nobumin/water_temperature/power_supply.md

# power_supply.md — 電源設計メモ

DS18B20 温度 BLE ファームウェアの**電源供給・省電力に関する検討資料**です。
Raspberry Pi Pico W と ESP-WROOM-32D の 2 ボードを対象とします。

> **数値についての注意**: 本書の消費電流はデータシート典型値からの**概算**であり、
> 本プロジェクトの実機では未実測です。実際の値は上下します。
> 判断が電池寿命に依存する場合は、[8. 実測方法](#8-実測方法) に従って測定してください。

---

## 1. 結論（先に要点）

| 問い | 答え |
| --- | --- |
| ボタン電池（CR2032 等）で動くか | **動きません**。電圧ではなく**電流**が足りません |
| 現実的な電池は | **Pico W + 単4×2**（または 1S LiPo）。ESP32 は電池運用に不向き |
| どこに繋ぐか | Pico W = **VSYS(39) / GND(38)**、ESP32 = **3V3 ピン / GND**（3.0〜3.6V のみ） |
| ESP32 に自作基板は必須か | **必須ではありません**。目標寿命次第で 4 段階の選択肢があります |
| deep sleep で長寿命化できるか | BLE で検温要求を受ける構成とは**両立しません**（[6 章](#6-省電力の選択肢)） |

---

## 2. ボタン電池が使えない理由

### 2.1 電池側の供給能力

| 電池 | 公称電圧 | 容量 | 取り出せる電流の目安 |
| --- | --- | --- | --- |
| CR2032 | 3.0V | 約 220mAh | 連続 **1mA 程度**（パルスで 15mA 前後） |
| CR2450 | 3.0V | 約 600mAh | 連続 3mA 程度 |

CR2032 は内部抵抗が新品で 10Ω 前後、消耗すると 100Ω を超えます。

### 2.2 ボード側の要求

| ボード | 起動時ピーク | BLE アドバタイズ中 |
| --- | --- | --- |
| ESP-WROOM-32D | **約 300mA** | 約 40〜80mA |
| Pico W | 約 100mA | 約 30〜50mA |

100mA を引こうとした瞬間に 1V 以上ドロップし、**ブラウンアウトリセットで起動すらしません**。
容量的にも、仮に動いたとしても数時間の世界です。

### 2.3 参考: なぜ BLE ビーコン製品はボタン電池で動くのか

ボタン電池で動く BLE 製品が Nordic nRF52 系ばかりなのは、**送信時電流が 5〜8mA と桁違いに小さい**ためです。
ESP32 は送信 130mA 超のため、コイン電池とは根本的に相性が悪いです。
deep sleep を入れても、送信パルスを賄うのに 1000µF 級のバルクコンデンサが必要になる計算です。

---

## 3. 実用的な電源の選択肢

| 電源 | Pico W | ESP32 DevKit |
| --- | --- | --- |
| **単4 × 2（3.0V）** | ◎ VSYS へ直結。**最も手軽** | ✕ 電圧不足 |
| 単3 × 2（3.0V） | ◎ 容量重視ならこちら | ✕ 電圧不足 |
| 単3 × 3（4.5V） | ◎ VSYS へ | △ 5V ピンでは LDO のドロップアウト不足気味 |
| 単3 × 4（6V） | ◎ VSYS へ | ○ 5V ピンへ（差分は熱として捨てるため非効率） |
| **1S LiPo（3.7V）** | ◎ VSYS へ直結。**最小サイズ** | △ 直結不可。要 3.3V レギュレータか 5V 昇圧 |
| モバイルバッテリー（USB 5V） | ◎ | ◎ 最も手軽 |

**Pico W のほうが電池運用は圧倒的に有利です。** VSYS が **1.8〜5.5V 対応の昇降圧レギュレータ**
入力になっており、電圧が下がっても昇圧して使い切れるためです。

### 3.1 体積あたりの実効エネルギー（目安）

| 電源 | 実効エネルギー | 体積の目安 |
| --- | --- | --- |
| 単3×4（ESP32・LDO 経由） | 約 5Wh | 60×58×17mm |
| 単3×2（Pico W・VSYS） | 約 4Wh | 30×58×17mm |
| **1S LiPo 1000mAh**（Pico W） | 約 3.1Wh | **35×20×5mm** |
| モバイルバッテリー 5000mAh | 約 13Wh | 90×60×12mm |

小容量帯では **LiPo が圧倒的に小型**です。ケースに収めるなら Pico W + 1S LiPo が最もコンパクトになります。

### 3.2 乾電池を選ぶ理由

サイズでは LiPo に劣りますが、次の利点があります。

- どこでも入手・交換できる
- 低温に強い（LiPo は氷点下で急激に性能が落ちる）
- 発火リスクが低く、輸送規制も緩い
- 充電回路が不要

屋外設置や、エンドユーザーが自分で電池交換する製品なら、多少大きくても乾電池が妥当な場合があります。

### 3.3 モバイルバッテリーの落とし穴

**多くのモバイルバッテリーは低電流だと自動で給電を停止します。**
「機器が外された」と判断する閾値がだいたい 50〜100mA 前後にあるためです。

- 現行ファーム（BLE 待受で 30〜50mA） → **製品によっては数十秒で切れます**
- deep sleep を実装した後（µA オーダー） → **ほぼ確実に切れます**

低電流モード付きの製品を選ぶか、常用電源にしない判断が必要です。

---

## 4. 接続図：Pico W（推奨構成）

写真と同じ向き（USB が上、アンテナが下）。

```
                    ┌────────── USB（上）──────────┐
          GP0    1 ─┤ ●                          ● ├─ 40  VBUS      （使わない）
          GP1    2 ─┤ ●                          ● ├─ 39  VSYS      ◄══ 電池 ＋
          GND    3 ─┤ ●                          ● ├─ 38  GND       ◄══ 電池 −
          GP2    4 ─┤ ●                          ● ├─ 37  3V3_EN    （GND に落とすと電源 OFF）
          GP3    5 ─┤ ●                          ● ├─ 36  3V3(OUT)  ◄── DS18B20 VDD ＋ 4.7kΩ
          GP4    6 ─┤ ●                          ● ├─ 35  ADC_VREF
          GP5    7 ─┤ ●                          ● ├─ 34  GP28
          GND    8 ─┤ ●                          ● ├─ 33  GND (AGND)
          GP6    9 ─┤ ●         Pico W           ● ├─ 32  GP27
          GP7   10 ─┤ ●                          ● ├─ 31  GP26
          GP8   11 ─┤ ●                          ● ├─ 30  RUN
          GP9   12 ─┤ ●                          ● ├─ 29  GP22
          GND   13 ─┤ ●                          ● ├─ 28  GND
          GP10  14 ─┤ ●                          ● ├─ 27  GP21
          GP11  15 ─┤ ●                          ● ├─ 26  GP20
          GP12  16 ─┤ ●                          ● ├─ 25  GP19
          GP13  17 ─┤ ●                          ● ├─ 24  GP18
          GND   18 ─┤ ●                          ● ├─ 23  GND
          GP14  19 ─┤ ●                          ● ├─ 22  GP17
  ◄──★    GP15  20 ─┤ ●                          ● ├─ 21  GP16
                    └───── アンテナ / CYW43（下）─────┘

  ◄──★  DS18B20 DQ ＋ 4.7kΩ で 3V3(OUT) へプルアップ
```

回路図として書くと次のとおりです。

```
   電池 ＋ ──[ ショットキー 1N5817 ]──┬────────── 39  VSYS
                                      │
                                  [ 100µF ]      ← 突入電流の緩和
                                      │
   電池 −  ─────────────────────────┴────────── 38  GND
                                                    │
   3V3(OUT) 36 ──┬──[ 4.7kΩ ]──┬                    │
                 │             │                    │
   DS18B20 VDD ──┘             │                    │
   DS18B20 DQ  ────────────────┴───────── GP15 (20) │
   DS18B20 GND ──────────────────────────────────────┘
```

### 4.1 注意点

- **直列ショットキーダイオードを推奨**します。USB を挿すと VBUS から内部ダイオード経由で
  VSYS に約 4.7V が現れるため、これが無いと一次電池（充電不可）に逆流します。
  USB を使うときは電池を外す運用なら省略できます。
- **3V3_EN（37 番）を GND に落とすとレギュレータが止まります。**
  ここにスライドスイッチを入れれば電源スイッチになります。
- **VBUS(40) や 3V3(OUT)(36) に電池を繋いではいけません。** 前者は USB へ逆流し、
  後者はレギュレータをバイパスします。

---

## 5. 接続図：ESP32 DevKit

```
              ┌──── アンテナ（写真の上）────┐
       3V3 ──┤ ●                          ● ├── GND   ◄══ 電池 −
        EN ──┤ ●                          ● ├── 23
       ▲▲▲
   ◄══ 電池 ＋（3.0〜3.6V に安定化されたもののみ）
        VP ──┤ ●                          ● ├── 22
        VN ──┤ ●                          ● ├── TX
        34 ──┤ ●                          ● ├── RX
        35 ──┤ ●                          ● ├── 21
        32 ──┤ ●                          ● ├── GND
        33 ──┤ ●                          ● ├── 19
        25 ──┤ ●                          ● ├── 18
        26 ──┤ ●                          ● ├── 5
        27 ──┤ ●                          ● ├── 17
        14 ──┤ ●                          ● ├── 16
        12 ──┤ ●                          ● ├── 4     ◄── DS18B20 DQ ★
       GND ──┤ ●                          ● ├── 0
        13 ──┤ ●                          ● ├── 2
        D2 ──┤ ●                          ● ├── 15
        D3 ──┤ ●                          ● ├── D1
       CMD ──┤ ●                          ● ├── D0
        5V ──┤ ●                          ● ├── CLK
       ▲▲
   4.5V 以上の電源はこちら（オンボード LDO 経由）
              └──── micro-USB（写真の下）────┘
```

電圧によって挿す場所が変わります。

| 電源電圧 | 接続先 | 備考 |
| --- | --- | --- |
| 3.0〜3.6V（安定化済み） | **3V3 ピン** | LDO をバイパス。逆接保護なし |
| 4.5V 以上 | **5V ピン** | オンボード AMS1117 経由。ドロップアウト約 1.1V |
| 3.7V（LiPo 直結） | **どちらも不可** | 3V3 には高すぎ、5V ピンには足りない。要レギュレータ |

### 5.1 注意点

1. **3V3 ピン給電中に USB を挿さないでください。** AMS1117 の出力と電池がぶつかります。
2. **DevKit は電池運用に向きません。** USB-シリアル変換の CP2102 とオンボード LDO が
   常時 5〜10mA を消費し、MCU 側をいくら絞っても板全体では下がりません。

---

## 6. 省電力の選択肢

### 6.1 モードの実力（ボード別）

| モード | ESP32 | RP2040 (Pico W) |
| --- | --- | --- |
| 通常動作（BLE 送信中） | 40〜80mA | 30〜50mA |
| light sleep（RAM 保持） | 約 0.8mA | SLEEP: 約 1.3mA |
| **deep sleep** | **約 10µA** | DORMANT: チップ単体 約 180µA |
| 起床方法 | RTC タイマ / GPIO / タッチ | **原則 GPIO のみ** |

- **ESP32**: `esp_hal` に `Rtc::sleep_deep()` / `sleep_light()` があり、タイマ起床も使えます。
- **RP2040**: `embassy-rp` に `dormant_sleep()` はありますが、「リセットか dormant-wake GPIO 割り込みでしか
  抜けられない」実装です。定期的に自力で起きるには外部 RTC か 32kHz 発振器が必要になります。
- **Pico W 固有の制約**: CYW43439 は電源を切ると、次回起動時に**数百 KB のファームウェア blob を
  SPI で転送し直す**必要があります（`scripts/fetch-cyw43-firmware.sh` で取得しているもの）。
  頻繁な sleep/wake は、この転送の時間とエネルギーが省電力分を食い潰します。

> **まとめ**: Pico W は「電池電圧の扱いは優秀だが deep sleep には不向き」、
> ESP32 は「deep sleep は得意だが DevKit ではその恩恵が出ない」という、やや噛み合わない特性です。

### 6.2 最大のトレードオフ

> **寝ている間は BLE アドバタイズが止まる = スマホから見えない。**

本ファームは**オンデマンド検温**（検温要求の GATT Write で 60 秒間だけ測定）ですが、
**その要求を受け取るには無線が生きている必要があります**。BLE の原理上の制約であり、
ライブラリの制限ではありません。

| 動作モデル | 見え方 | 消費電流 |
| --- | --- | --- |
| **A. 常時アドバタイズ待受**（現行） | いつでも要求できる | 大 |
| **B. 定期ビーコン**（deep sleep） | 送信窓に居合わせないと見えない | 極小 |
| **C. 物理ボタン + deep sleep** | ボタンを押せば即応答 | 極小 |

現行ファームは **A** です。**C** に移行する場合も、トリガを `ble::REQUEST` シグナルへ
合流させれば BLE 側のコードは変更不要な構造にしてあります（`specification.md` 5.4 節）。

### 6.3 消費電流の内訳（重要）

**オンデマンド検温化だけでは消費電流はあまり下がりません。**

| 要素 | 支配度 | オンデマンド化で下がるか |
| --- | --- | --- |
| **CPU と無線のアイドル電流** | **最大** | **下がらない** |
| アドバタイズ間隔 160ms → 1000ms | 中 | 下がる（実装済み） |
| 測定の停止（DS18B20 の変換） | 小 | 下がる（実装済み） |
| Notify の停止 | 小 | 下がる（実装済み） |

大幅に下げるには **light sleep / modem sleep のパワーマネジメントが別途必要**です。
現行ファームはこれを一切設定していません。

---

## 7. 電池寿命の試算

**前提**: 1 日 10 回・各 1 分の検温、単4×2（約 1000mAh）。いずれも**未実測の概算**です。

| 構成 | 待機電流 | 目安 |
| --- | --- | --- |
| Pico W（現行・オンデマンドのみ） | 15〜30mA | **1.5〜3 日** |
| ESP32 DevKit（現行） | 30〜50mA | 約 1 日 |
| ESP32 自作基板（＋light sleep） | 3〜10mA | 4 日〜2 週間 |
| ESP32 自作基板（ボタン + deep sleep） | 約 10µA | **約 5 ヶ月** |

最終行まで到達すると、寿命が**待機電流ではなく検温回数で決まる**ようになります。ここが設計の分かれ目です。

---

## 8. 実測方法

概算に頼らず、実機で測るのが確実です。

1. 電池と基板の間に**テスターを直列**に挿入する（電流モード、mA レンジ）
2. 次の 3 状態で測る
   - 待受中（検温要求を出していない状態）
   - 検温中（Write 直後の 60 秒間）
   - 起動時のピーク（可能なら）
3. 結果を `test_procedure.md` の実機記録に残す

ファームウェアの変更前後で比較すれば、省電力施策の効果を数値で確認できます。

---

## 9. 製品化する場合の検討事項

PoC から製品へ進める段階で必要になる項目です。

### 9.1 基板の選択肢

| | 方法 | 待機電流 | 手間 |
| --- | --- | --- | --- |
| **A** | DevKit をそのまま使う | 30〜50mA | なし |
| **B** | DevKit を改造（CP2102 の電源カット、LDO バイパス） | 改善するが保証外 | 中・要はんだ作業 |
| **C** | 電池運用向けの既製 ESP32 ボードを選ぶ | 大幅改善 | 小・買い替えのみ |
| **D** | ESP32 モジュール直載せの自作基板 | 最良 | 大 |

判断基準:

- **USB 給電が前提で電池は予備** → A で十分
- **数日もてばよい** → A か C
- **数週間〜数ヶ月** → C か D ＋ light sleep 実装が必須

### 9.2 技適（日本国内）

ESP-WROOM-32D は**モジュール単体で工事設計認証を取得済み**です。モジュールを改変せず、
指定された条件（内蔵 PCB アンテナをそのまま使う等）を守れば、原則として最終製品での
再認証は不要になります。ただし**製品に技適マークの表示義務**があり、条件の詳細は
モジュールの認証情報で確認が必要です。

> 自己判断せず、Espressif の資料か認証機関に確認してください。

### 9.3 回路設計

| 項目 | 内容 |
| --- | --- |
| 電源 | DevKit の AMS1117 は効率・待機電流とも悪い。電池駆動なら低 Iq LDO か降圧 DC-DC へ |
| 書き込み | USB-シリアルを載せるか、UART + EN/IO0 をテストパッド（ポゴピン用）として出す。OTA を実装すれば量産後の更新が楽 |
| アンテナ | モジュールのアンテナ部は基板から張り出させ、直下と周囲を**銅箔・GND 禁止**にする。金属ケースは BLE を大きく殺す |
| コネクタ | DS18B20 が防水プローブなら JST XH / 端子台 / 屋外なら M12 など |

### 9.4 1-Wire の外部配線（本プロジェクト固有）

センサをケーブルで外に出す＝**ESD とノイズの入口**になります。ブレッドボードでは不要でも、
製品では次を検討してください。

- DQ に直列 100Ω 程度 ＋ **ESD/TVS ダイオード**
- ケーブルが長い（数 m 以上）場合はプルアップを 2.2kΩ 程度に下げる、または 1-Wire ラインドライバ

ESP32 のソフトビットバンギングは**タイミング余裕が小さい**ため（`specification.md` の
「µs 待機の実装はボード固有」節を参照）、ケーブルが伸びるほど不利です。製品化するなら
**RMT ペリフェラルによるハードウェア生成**への移行を検討する価値があります。

### 9.5 ボード選定の見直し

新規に基板を設計するなら、**ESP32-C3 / C6 への移行**を検討する価値があります。

- **stable Rust で扱える**（RISC-V）。`espup` や Xtensa フォークのツールチェーンが不要になり、CI も単純化される
- BLE 5.x 対応、モジュール単価も安い
- 本プロジェクトの `core` クレートはそのまま流用でき、`ble.rs` もほぼ同一のはず

コイン電池で数年動く BLE センサを目指す場合は、Nordic nRF52 系が本命です。

---

## 10. 関連ドキュメント

| ファイル | 内容 |
| --- | --- |
| `specification.md` | 詳細仕様（配線図・BLE 定義・オンデマンド検温の状態機械） |
| `environment.md` | ローカル環境構築・実機セットアップ・トラブルシュート |
| `test_procedure.md` | テスト手順（ホスト / CI / 実機） |
| `README.md` | 概要 |
