nobumin/water_temperature/firmware/build.rs

//! ビルドスクリプト: リンカに memory.x を渡す。
use std::env;
use std::fs::File;
use std::io::Write;
use std::path::PathBuf;

fn main() {
    // memory.x を OUT_DIR に配置し、リンカの検索パスに追加する。
    let out = PathBuf::from(env::var("OUT_DIR").unwrap());
    File::create(out.join("memory.x"))
        .unwrap()
        .write_all(include_bytes!("memory.x"))
        .unwrap();
    println!("cargo:rustc-link-search={}", out.display());
    println!("cargo:rerun-if-changed=memory.x");
    println!("cargo:rerun-if-changed=build.rs");
}
