nobumin/water_temperature/(commit log)

2026-07-05 chore: initialize repository scaffold
    READMEと.gitignoreを追加し、本番ブランチmainの基盤を作成。
2026-07-05 feat: DS18B20 温度 BLE ファームウェアの初期実装
    Raspberry Pi Pico W + DS18B20 の温度を BLE で提供するファームウェアと、
    運用ルール・仕様・手順のドキュメント一式を追加。
    - core: ハードウェア非依存の中核ロジック(温度変換・CRC8・ESS エンコード)
    + ホスト単体テスト15件(実機不要でCI完結)
    - firmware: embassy + cyw43 + trouble-host で
    (1)非接続アドバタイズ(Service Data ESS) (2)接続型GATT(ESS Temperature)
    の両対応。1-Wire ビットバンギング DS18B20 ドライバ搭載
    - CI: fmt/clippy/core test/firmware クロスビルド(thumbv6m)
    - docs: CLAUDE.md(運用ルール), specif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
2026-07-05 docs: Copilotレビューの実行自体も事前確認を必須化
    レビュー依頼(実行)そのものをユーザー確認なしに行わない旨、および
    レビュー→修正サイクルを自律的に繰り返さない旨をCLAUDE.mdに明記。
2026-07-05 fix: Copilotレビュー指摘対応(アドレス静的ランダム化・コメント修正)
    - ble.rs: 固定アドレスを静的ランダムアドレス要件(最上位バイト上位2bit=11)に修正
    - ble.rs: NO_READING のコメントを実装(未測定時は温度0を載せる)に合わせて修正
    - ds18b20.rs: CRC計算範囲コメントを byte0〜7 の8バイト に明確化
    [ble.rs]
2026-07-05 fix: fetch-cyw43-firmware.sh を失敗時に非0終了させる
    blob 取得に1件でも失敗したら失敗一覧を表示して exit 1 する。
    握りつぶして success に見えるのを防ぎ、ビルド前に検知できるようにする。
    (Copilotレビュー指摘対応)
2026-07-05 fix: エラー分類とログを改善(Copilotレビュー指摘対応)
    - onewire.rs: reset 失敗時にバスレベルで Disconnected(High)/NoResponse(Low)
    を判定し、specification.md の分類と整合させる(absence_error 追加)
    - ble.rs: encode_slice / advertise の失敗を握りつぶさず warn! で記録してから
    None を返すようにし、広告不成立時のデバッグを容易にする
    [ble.rs, onewire.rs]
2026-07-06 fix: BLE のエラーログ追加とGATTテーブル鮮度維持(Copilotレビュー指摘対応)
    - ble.rs: with_attribute_server 失敗時に warn! を出力してから None を返す
    - ble.rs: notify_task で未測定時も GATT テーブルを常に更新(0を格納)し、
    Read が古い値を返し続ける問題を解消(仕様「Readは最新値」と整合)
    [ble.rs]
2026-07-15 feat: CYW43 blob 取得スクリプトの PowerShell 版を追加
    Windows で bash が無くても blob を取得できるよう fetch-cyw43-firmware.ps1 を追加。
    bash 版と同じ挙動(4 blob 取得・失敗時は非0終了)。
    environment.md と cyw43-firmware/README.md に Windows(PowerShell)手順を追記。
2026-07-15 docs: Pico W のピン配置図を specification.md に追記
    DS18B20 の結線ピン(GP15=物理20/DQ, 3V3(OUT)=36/VDD, GND=38)の物理位置が
    分かるよう、Pico W 40 ピンの ASCII 配置図と対応表を 2.2 配線 に追加。
    environment.md からも該当図への参照を追記。
2026-08-08 feat: ESP-WROOM-32D 版ファームウェアを追加(Pico W と両対応)
    DS18B20 の温度を BLE で提供するファームウェアを ESP32 へ移植し、
    Pico W 版と併存させる。中核ロジック(core)は両ファームで共有する。
    firmware-esp32/ (新規, 独立ワークスペース):
    - esp-hal 1.1 / esp-radio 0.18(ble) / esp-rtos 0.3(embassy) / trouble-host
    - BT はチップ内蔵のため CYW43 blob が不要
    - DS18B20 データ線は GPIO4(GPIO15 は ESP32 ではストラッピングピンのため回避)
    - onewire.rs は GPIO をオープンドレイン+入力有効で駆動。手順/タイミングは Pico W 版と同一
    - ble.rs は Pico W 版と同一ロジッ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
2026-08-08 fix: ESP32 のリリースプロファイルを公式例に合わせる
    opt-level="s" + fat LTO では PHY/BT のプリビルド blob から ets_delay_us /
    memcpy / __divdf3 を呼ぶ箇所の配置が変わり、リンクで
    dangerous relocation: windowed longcall crosses 1GB boundary
    となって失敗していた。trouble 公式 esp32 例と同じ
    opt-level=3 + thin LTO + codegen-units=1 に揃える。
2026-08-08 fix: ESP32 のリンカスクリプト(-Tlinkall.x)を指定
    esp-pacs の割り込みベクタ(__EXTERNAL_INTERRUPTS)が参照する
    WIFI_MAC / GPIO / UART0 等のデフォルトハンドラは esp-hal のリンカスクリプトが
    PROVIDE する。これが未指定だったため undefined reference となりリンクに失敗していた。
    env RUSTFLAGS は .cargo/config.toml の rustflags を置き換えるため、
    CI ジョブ側にも同じフラグを設定し、両方を同期させる旨をコメントに明記した。
    esp32c3(RISC-V) 版として同一ソースをビルドし、リンクまで成功することを確認済み。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
2026-08-08 docs/ci: Copilot レビュー指摘に対応
    - ci.yml: firmware-esp32 ジョブに clippy(-D warnings) ステップを追加。
    RUSTFLAGS に -D warnings を足すと build-std や git 由来 esp-* の上流警告で
    落ちるため、自クレートのみを厳格化する方針を採り理由をコメントに明記。
    - test_procedure.md: CI 各ジョブの説明を実コマンドに合わせて修正。
    ESP32 の L2 手順にも clippy を追加し、期待結果の文言と手順を一致させた。
    - README.md: espup install 後に export-esp.sh/ps1 の読み込みが必要な旨を追記。
2026-08-09 fix(esp32): embassy クレート分裂によるタイマ不動作を修正
    実機で温度が 0.00 のまま更新されず、`DS18B20` のログが 1 行も出ない
    不具合を修正する。
    原因は `[patch.crates-io]` が `embassy-executor` のみを git rev へ固定し、
    `embassy-time` 系を crates.io のまま残していたこと。その結果
    `embassy-executor-timer-queue` が git 版と crates.io 版の 2 つに分裂していた。
    このクレートは integrated timer queue の状態をタスクヘッダ内に保持するため、
    分裂すると esp-rtos のタイムドライバが `schedule_wake()` する先と
    エグゼキュータがタスクを管理する先が別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
2026-08-09 fix(esp32): 1-Wire の µs 待機を ROM 実装へ変更し CRC エラーを解消
    実機で `CrcMismatch` が多発し、時折全 0xFF の `Disconnected` になる問題に対応する。
    原因は `esp_hal::delay::Delay` のオーバーヘッド。ESP32 の `Delay` は内部で
    `Instant::now()` をループで呼ぶが、ESP32 の `Instant::now()` は TIMG0 の LACT
    タイマを読む実装で、更新完了ビットが無いため下位 32bit が変化するまで
    ポーリングする。1 回の呼び出しに µs オーダーのコストが乗るため、
    `delay_micros(6)` が実際には十数 µs かかる。
    1-Wire の読み取りは立ち下がりから 15µs 以内にサンプ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
    [main.rs, onewire.rs]
2026-08-10 feat: オンデマンド検温(要求受信 → 60 秒送信 → 待受)に対応
    常時測定・常時 Notify をやめ、ユーザからの検温要求を受けてから
    一定時間だけ測定・送信する方式へ変更する。
    要件:
    1. 検温要求イベントで検温を開始する
    2. 要求受信後 60 秒間、温度データを送信する
    3. 60 秒経過したら次の要求まで待受
    4. 60 秒以内に再要求を受けたら、その時点から更に 60 秒継続する
    要件 4 は「受信時刻を起点に 60 秒へ取り直すスライディング方式」として実装した
    (残り時間への加算ではない)。
    ## 動作モデル
    IDLE(待受) ── 検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
2026-08-10 fix: Copilot レビュー指摘に対応(検温ウィンドウの精度向上)
    ユーザー承認のうえ、指摘 3 件のうち 2 件をコード修正、1 件を仕様明記で対応した。
    ## 指摘 1: 検温停止が最大 2.75 秒遅れる(対応)
    `while Instant::now() < deadline` の判定がループ先頭にしかなく、期限到達後も
    `Timer::after_secs(SENSOR_PERIOD_SECS)` を待ち切っていた。測定 750ms + 待機 2 秒で
    最大約 2.75 秒の超過が発生しうる。
    `select3` に `Timer::at(deadline)` を加え、期限到達で即座にループを抜けるようにした。
    ## 指摘 2: 延長の起点が最大 750ms ずれる(対応)
    `REQUEST.signal(())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
    [ble.rs, main.rs]
2026-08-31 docs: 電源設計メモ(power_supply.md)を追加
    これまでチャットで検討していた電源供給まわりの内容を、独立した資料として
    リポジトリに残す。
    内容:
    - ボタン電池(CR2032 等)が使えない理由。電圧ではなく電流が不足する
    (CR2032 は連続 1mA 程度だが、ESP32 の起動時ピークは約 300mA)
    - 実用的な電源の選択肢と、体積あたりの実効エネルギー比較
    - 接続図: Pico W は VSYS(39)/GND(38)、ESP32 は 3V3 ピン/GND(3.0〜3.6V のみ)
    逆流防止ショットキーと 3V3_EN による電源スイッチの注記も含む
    - モバイルバッテリーが低電流で自動停止する落と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
2026-09-03 feat(webapp): Web Bluetooth クライアント(HTML + JS)を追加
    Android Chrome から温度を取得するシンプルな Web UI を追加する。
    ボタン 1 つで「接続 → Notify 購読 → 検温要求」までを行い、
    温度と残り時間を表示する。
    ## 構成
    webapp/index.html の 1 ファイルのみ。外部依存・ビルド手順なし。
    そのまま静的配信すれば動作する(GitHub Pages 等)。
    ## 動作
    1. 「温度を取得」→ デバイス選択(namePrefix = PicoTemp)→ 接続
    2. ESS Temperature(0x2A6E)の Notify を購読
    3. 検温制御サービスの検温要求 characteristic へ 1 バイト Write
    4. 約 2 秒ごとに温度を更新。60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
2026-09-03 fix(webapp): 接続途中失敗後の TypeError を修正(Copilot レビュー対応)
    ユーザー承認のうえ、指摘 3 件のうち 2 件を対応、1 件は不対応とした。
    ## 指摘 1: 接続途中失敗後の TypeError(対応)
    device.gatt.connect() が成功した後に getPrimaryService() が失敗すると、
    device.gatt.connected は true のまま requestChar が null で残る。
    次回クリックで `!device || !device.gatt.connected` が false となり
    connect() をスキップするため、sendRequest() が
    requestChar.writeValueWithResponse を参照して TypeError になっていた。
    connect() を ensureConnected() へ改め、「デバイス選択 / GATT 接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
2026-09-06 chore: 公開に備えてローカル環境情報を秘匿化し LICENSE を追加
    パブリック公開の前段として、現行ファイルから環境固有の情報を除去する。
    ## 秘匿化した内容
    - **ローカル作業ディレクトリのパス**（`CLAUDE.md` 7 章、`environment.md` 0 章）
    業務ドメインを含むパスがそのまま記載されており、公開すると
    ディレクトリ構成と所属の手がかりが露出するため。
    - CLAUDE.md: 運用ルール自体は維持し、具体パスの記載をやめた。
    パスはセッション開始時にユーザーから提示される前提とする。
    - environment.md: 「クローン先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
2026-09-07 docs: README に参考画像セクションを追加
    ボード（ESP-WROOM-32D / Raspberry Pi Pico W）と DS18B20 防水プローブの
    外観写真を README から参照できるようにする。
    - ハードウェア比較表の直後に「参考画像」節を追加
    - 画像は `docs/images/` に配置する前提（ds18b20.jpg / boards.jpg）
    - 線色（赤=VDD / 黒=GND / 黄=DQ）とプルアップ必須の注意を併記
    - リポジトリ構成表に `docs/images/` を追記
    画像ファイル本体は別コミットで追加する。
2026-09-07 docs: 参考画像を追加
